Archfx/FPGA-DepthMap-Basys3/IMG/Bat2.png

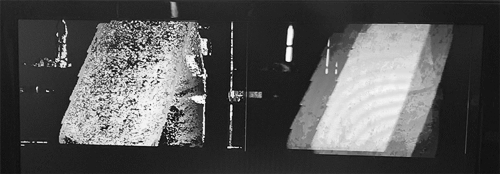
IMG/Bat2.png
