Archfx/FPGA-DepthMap-Basys3/IMG/Bat.png

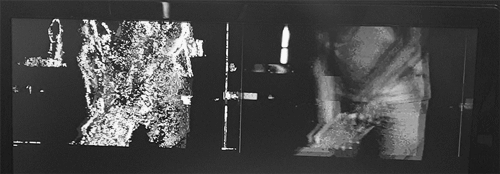
IMG/Bat.png
