Archfx/FPGA-DepthMap-Basys3/IMG/Bat_av_crop.png

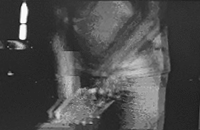
IMG/Bat_av_crop.png
