Archfx/FPGA-DepthMap-Basys3/IMG/Bat_crop.png

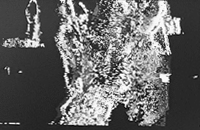
IMG/Bat_crop.png
