Archfx/FPGA-DepthMap-Basys3/(threads)

Thread 1 (2020-06-18):

Error during Synthesis/Implementation due to "Black box cells" (Missing module files?)

WillPastor, 2020-06-18:
Hi, I'm trying to get this working on my Basys 3, but it seems that there are files missing, which are required by Vivado to successfully run through Implementation. The missing files are those defining the modules: disparity_ram , frame_buffer , and Clocks, although I believe I can easily replace the missing "Clocks" by using Xilinx' Clocking Wizard in Core Gen. For the others, would you be willing to either upload these files, or if you are unable to provide them, give me some information on the functionality of those modules so I may try to re-write them myself?
Any help would be greatly appreciated.

Here are the error messages after implementation fails:
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

Archfx, 2020-06-18:
Hi Will,
all these missing modules were generated using inbuilt IP cores. Since you have solved the clocking issue, I believe you would be able to configure the Blockram issue as well if I give you their parameters.

Archfx, 2020-06-18:
All the buffers are dual-port block rams and configurations are as follows,

**Disparity_ram:**
           **width** : 8bits
           **Depth** : 76800 (320*240)
           _does not include an enable pin_

**Frame_buffer:**
           **width** : 4bits
           **Depth** : 76800 (320*240)
           _Includes an enable pin_

WillPastor, 2020-06-19:
Thank you! Everything seems to be working now except for the Clocks. I'm getting an error after Implementation:
`[Timing 38-282] The design failed to meet the timing requirements. Please see the timing summary report for details on the timing violations.`

I probably have some of the settings wrong in the Clocking Wizard. Could you tell me what settings you used?
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

Archfx, 2020-06-20:
This might be due to the fact that later I changed CLK_MAIN (100Hz) clock to 50Hz, Please try changing it.

WillPastor, 2020-06-22:
Thank you very much for your help. It finished generating a bitstream and writing to the FPGA.

I also wanted to ask if you could provide documentation on what the buttons are supposed to do?

Additionally, I would like to use code from this project for an academic project. I do not see any license info in this repo, so I wanted to make sure I know your preferences on use of your code and how to properly give credit.

I could open a new issue for these if you would prefer, since the original problem is solved.
Thanks for all the help!

Archfx, 2020-06-23:
Great, I have updated the repo with an MIT license, You can include my name "Aruna Jayasena" for credits. Regarding the buttons, I will update the documentation.  I will close this Issue since the original issue has been fixed now. If you have any other, feel free to open a new one. Good luck!!!

Closed 2020-06-23.

Thread 3 (2020-07-14):

Noise in Camera Signal

WillPastor, 2020-07-14:
So, I have both cameras connected and the bitstream sent to my Basys3 board. Everything is working correctly, but the VGA output is showing that the cameras must be picking up a **lot** of noise across the entire frame, and it interferes a lot with the disparity map from what I see on the screen. Do you have any suggestions or thoughts on this issue? The setting is a well-lit (but not super-brightly lit) indoor room, if that matters. Thanks!

Archfx, 2020-07-15:
This must be due to some sort of error or lose connection in the wiring, Better to check the cameras individually and recheck the connections, I glued the connectors with hot glue to get rid of the same issue. Light is affecting the performance because OV7670 cameras are very weak in low light. Also, don't forget to focus the lens on both the cameras correctly. :smile:

WillPastor, 2020-07-19:
All the wires are now firmly in place, but I'm still having some trouble. It seems like some of the issue(s) might be caused by timing violations. I'm very new to FPGA development so I did not realize at first how much this would affect performance. I've tried using more aggressive settings for optimization during synthesis and implementation, but not much luck, all runs still have timing violation. Do you have any suggestions such as what timing constraints you used, and/or what directives you used for synthesis/implementation? I was just going through the Timing Constraints Wizard and I am not too sure what would be good values to enter for many of the fields like input and output delays, etc.
Thanks again!

Archfx, 2020-07-23:
I guess you will be able to optimize the parameters to obtain good results, But I suggest you to test each and individual cameras separately, As I had to do lot of trial and error to find the issues. For some issues, I had to change the internal register values of the cameras.

Closed 2023-05-22.

Thread 4 (2020-07-22):

160x120 Resolution Address Width

WillPastor, 2020-07-22:
Hi, I tried setting the resolution to 160x120 by changing these lines in depthmap.vhd from:
```
rez_160x120 <= '0';
rez_320x240 <= '1';
```
to:
```
rez_160x120 <= '1';
rez_320x240 <= '0';
```
I also changed the depth of the Dual Port RAMs to 19200 (160*120) instead of 76800. This led to some issues, since the Address Width is now 15 bits instead of 17. What is the intended way to make the lower resolution work? I tried updating the width to 15 bits throughout all of the code, but this continued to give me errors. Right now I'm seeing if it works to just leave the rest of the code as it was (17 bit address), but in the port-mapping for the RAM instances, use only 15 bits of whatever signal it is connected to. For example:
```Inst_frame_buffer_l: frame_buffer PORT MAP(
		addrb => address_left(14 downto 0),
		clkb   => clk_camera,--CLK100,
		doutb  => rddata_l,
		enb    =>'1',
		clka   => ov7670_pclk_l,
		addra => wr_addr_l(14 downto 0),```
I am worried this might cause issues later on even if it works at the moment, unless this is the intended way to handle it?
Thanks!

Archfx, 2020-07-23:
Actually this was the intended method for my application to change the resolution, Therefore it won't affect the results. I couldn't have found a way to modify the block ram depths using an API, Therefore I kept it like that. :smile:

Closed 2021-08-04.
