Archfx/FPGA-DepthMap-Basys3/depthMap.runs/synth_1/.Xil/DepthMap_propImpl.xdc

set_property SRC_FILE_INFO {cfile:c:/Users/Aruna/Documents/Vivado/DepthMap_implementaion_basys3_320x240_With_UART/depthMap.srcs/sources_1/ip/Clocks/Clocks.xdc rfile:../../../depthMap.srcs/sources_1/ip/Clocks/Clocks.xdc id:1 order:EARLY scoped_inst:Inst_ClockDev/inst} [current_design]
set_property SRC_FILE_INFO {cfile:C:/Users/Aruna/Documents/Vivado/DepthMap_implementaion_basys3_320x240_With_UART/depthMap.srcs/constrs_1/imports/new/basys3_xdc.xdc rfile:../../../depthMap.srcs/constrs_1/imports/new/basys3_xdc.xdc id:2} [current_design]
current_instance Inst_ClockDev/inst
set_property src_info {type:SCOPED_XDC file:1 line:57 export:INPUT save:INPUT read:READ} [current_design]
set_input_jitter [get_clocks -of_objects [get_ports clk_in1]] 0.1
current_instance
set_property src_info {type:XDC file:2 line:5 export:INPUT save:INPUT read:READ} [current_design]
set_property PACKAGE_PIN W5 [get_ports clk100]
set_property src_info {type:XDC file:2 line:13 export:INPUT save:INPUT read:READ} [current_design]
set_property PACKAGE_PIN G19 [get_ports {vga_r[0]}]
set_property src_info {type:XDC file:2 line:15 export:INPUT save:INPUT read:READ} [current_design]
set_property PACKAGE_PIN H19 [get_ports {vga_r[1]}]
set_property src_info {type:XDC file:2 line:17 export:INPUT save:INPUT read:READ} [current_design]
set_property PACKAGE_PIN J19 [get_ports {vga_r[2]}]
set_property src_info {type:XDC file:2 line:19 export:INPUT save:INPUT read:READ} [current_design]
set_property PACKAGE_PIN N19 [get_ports {vga_r[3]}]
set_property src_info {type:XDC file:2 line:21 export:INPUT save:INPUT read:READ} [current_design]
set_property PACKAGE_PIN N18 [get_ports {vga_b[0]}]
set_property src_info {type:XDC file:2 line:23 export:INPUT save:INPUT read:READ} [current_design]
set_property PACKAGE_PIN L18 [get_ports {vga_b[1]}]
set_property src_info {type:XDC file:2 line:25 export:INPUT save:INPUT read:READ} [current_design]
set_property PACKAGE_PIN K18 [get_ports {vga_b[2]}]
set_property src_info {type:XDC file:2 line:27 export:INPUT save:INPUT read:READ} [current_design]
set_property PACKAGE_PIN J18 [get_ports {vga_b[3]}]
set_property src_info {type:XDC file:2 line:29 export:INPUT save:INPUT read:READ} [current_design]
set_property PACKAGE_PIN J17 [get_ports {vga_g[0]}]
set_property src_info {type:XDC file:2 line:31 export:INPUT save:INPUT read:READ} [current_design]
set_property PACKAGE_PIN H17 [get_ports {vga_g[1]}]
set_property src_info {type:XDC file:2 line:33 export:INPUT save:INPUT read:READ} [current_design]
set_property PACKAGE_PIN G17 [get_ports {vga_g[2]}]
set_property src_info {type:XDC file:2 line:35 export:INPUT save:INPUT read:READ} [current_design]
set_property PACKAGE_PIN D17 [get_ports {vga_g[3]}]
set_property src_info {type:XDC file:2 line:37 export:INPUT save:INPUT read:READ} [current_design]
set_property PACKAGE_PIN P19 [get_ports vga_hsync]
set_property src_info {type:XDC file:2 line:39 export:INPUT save:INPUT read:READ} [current_design]
set_property PACKAGE_PIN R19 [get_ports vga_vsync]
set_property src_info {type:XDC file:2 line:43 export:INPUT save:INPUT read:READ} [current_design]
set_property PACKAGE_PIN U16 [get_ports {config_finished_l}]
set_property src_info {type:XDC file:2 line:46 export:INPUT save:INPUT read:READ} [current_design]
set_property PACKAGE_PIN L1 [get_ports {config_finished_r}]
set_property src_info {type:XDC file:2 line:52 export:INPUT save:INPUT read:READ} [current_design]
set_property PACKAGE_PIN W19 [get_ports btnl]
set_property src_info {type:XDC file:2 line:54 export:INPUT save:INPUT read:READ} [current_design]
set_property PACKAGE_PIN T17 [get_ports btnr]
set_property src_info {type:XDC file:2 line:56 export:INPUT save:INPUT read:READ} [current_design]
set_property PACKAGE_PIN T18 [get_ports btnp]
set_property src_info {type:XDC file:2 line:58 export:INPUT save:INPUT read:READ} [current_design]
set_property PACKAGE_PIN U17 [get_ports btnm]
set_property src_info {type:XDC file:2 line:61 export:INPUT save:INPUT read:READ} [current_design]
set_property PACKAGE_PIN V17 [get_ports {btnc}]
set_property src_info {type:XDC file:2 line:74 export:INPUT save:INPUT read:READ} [current_design]
set_property PACKAGE_PIN A14 [get_ports {ov7670_pwdn_l}]
set_property src_info {type:XDC file:2 line:77 export:INPUT save:INPUT read:READ} [current_design]
set_property PACKAGE_PIN A16 [get_ports {ov7670_data_l[0]}]
set_property src_info {type:XDC file:2 line:80 export:INPUT save:INPUT read:READ} [current_design]
set_property PACKAGE_PIN B15 [get_ports {ov7670_data_l[2]}]
set_property src_info {type:XDC file:2 line:83 export:INPUT save:INPUT read:READ} [current_design]
set_property PACKAGE_PIN B16 [get_ports {ov7670_data_l[4]}]
set_property src_info {type:XDC file:2 line:86 export:INPUT save:INPUT read:READ} [current_design]
set_property PACKAGE_PIN A15 [get_ports {ov7670_reset_l}]
set_property src_info {type:XDC file:2 line:89 export:INPUT save:INPUT read:READ} [current_design]
set_property PACKAGE_PIN A17 [get_ports {ov7670_data_l[1]}]
set_property src_info {type:XDC file:2 line:92 export:INPUT save:INPUT read:READ} [current_design]
set_property PACKAGE_PIN C15 [get_ports {ov7670_data_l[3]}]
set_property src_info {type:XDC file:2 line:95 export:INPUT save:INPUT read:READ} [current_design]
set_property PACKAGE_PIN C16 [get_ports {ov7670_data_l[5]}]
set_property src_info {type:XDC file:2 line:101 export:INPUT save:INPUT read:READ} [current_design]
set_property PACKAGE_PIN K17 [get_ports {ov7670_data_l[6]}]
set_property src_info {type:XDC file:2 line:104 export:INPUT save:INPUT read:READ} [current_design]
set_property PACKAGE_PIN M18 [get_ports ov7670_xclk_l]
set_property src_info {type:XDC file:2 line:107 export:INPUT save:INPUT read:READ} [current_design]
set_property PACKAGE_PIN N17 [get_ports ov7670_href_l]
set_property src_info {type:XDC file:2 line:110 export:INPUT save:INPUT read:READ} [current_design]
set_property PACKAGE_PIN P18 [get_ports ov7670_siod_l]
set_property src_info {type:XDC file:2 line:114 export:INPUT save:INPUT read:READ} [current_design]
set_property PACKAGE_PIN L17 [get_ports {ov7670_data_l[7]}]
set_property src_info {type:XDC file:2 line:117 export:INPUT save:INPUT read:READ} [current_design]
set_property PACKAGE_PIN M19 [get_ports ov7670_pclk_l]
set_property src_info {type:XDC file:2 line:119 export:INPUT save:INPUT read:READ} [current_design]
set_property CLOCK_DEDICATED_ROUTE FALSE [get_nets {ov7670_pclk_l_IBUF}]
set_property src_info {type:XDC file:2 line:121 export:INPUT save:INPUT read:READ} [current_design]
set_property PACKAGE_PIN P17 [get_ports ov7670_vsync_l]
set_property src_info {type:XDC file:2 line:124 export:INPUT save:INPUT read:READ} [current_design]
set_property PACKAGE_PIN R18 [get_ports ov7670_sioc_l]
set_property src_info {type:XDC file:2 line:130 export:INPUT save:INPUT read:READ} [current_design]
set_property PACKAGE_PIN J1 [get_ports {ov7670_pwdn_r}]
set_property src_info {type:XDC file:2 line:133 export:INPUT save:INPUT read:READ} [current_design]
set_property PACKAGE_PIN L2 [get_ports {ov7670_data_r[0]}]
set_property src_info {type:XDC file:2 line:136 export:INPUT save:INPUT read:READ} [current_design]
set_property PACKAGE_PIN J2 [get_ports {ov7670_data_r[2]}]
set_property src_info {type:XDC file:2 line:139 export:INPUT save:INPUT read:READ} [current_design]
set_property PACKAGE_PIN G2 [get_ports {ov7670_data_r[4]}]
set_property src_info {type:XDC file:2 line:142 export:INPUT save:INPUT read:READ} [current_design]
set_property PACKAGE_PIN H1 [get_ports {ov7670_reset_r}]
set_property src_info {type:XDC file:2 line:145 export:INPUT save:INPUT read:READ} [current_design]
set_property PACKAGE_PIN K2 [get_ports {ov7670_data_r[1]}]
set_property src_info {type:XDC file:2 line:148 export:INPUT save:INPUT read:READ} [current_design]
set_property PACKAGE_PIN H2 [get_ports {ov7670_data_r[3]}]
set_property src_info {type:XDC file:2 line:151 export:INPUT save:INPUT read:READ} [current_design]
set_property PACKAGE_PIN G3 [get_ports {ov7670_data_r[5]}]
set_property src_info {type:XDC file:2 line:157 export:INPUT save:INPUT read:READ} [current_design]
set_property PACKAGE_PIN J3 [get_ports {ov7670_data_r[6]}]
set_property src_info {type:XDC file:2 line:160 export:INPUT save:INPUT read:READ} [current_design]
set_property PACKAGE_PIN L3 [get_ports ov7670_xclk_r]
set_property src_info {type:XDC file:2 line:163 export:INPUT save:INPUT read:READ} [current_design]
set_property PACKAGE_PIN M2 [get_ports ov7670_href_r]
set_property src_info {type:XDC file:2 line:166 export:INPUT save:INPUT read:READ} [current_design]
set_property PACKAGE_PIN N2 [get_ports ov7670_siod_r]
set_property src_info {type:XDC file:2 line:170 export:INPUT save:INPUT read:READ} [current_design]
set_property PACKAGE_PIN K3 [get_ports {ov7670_data_r[7]}]
set_property src_info {type:XDC file:2 line:173 export:INPUT save:INPUT read:READ} [current_design]
set_property PACKAGE_PIN M3 [get_ports ov7670_pclk_r]
set_property src_info {type:XDC file:2 line:175 export:INPUT save:INPUT read:READ} [current_design]
set_property CLOCK_DEDICATED_ROUTE FALSE [get_nets {ov7670_pclk_r_IBUF}]
set_property src_info {type:XDC file:2 line:177 export:INPUT save:INPUT read:READ} [current_design]
set_property PACKAGE_PIN M1 [get_ports ov7670_vsync_r]
set_property src_info {type:XDC file:2 line:180 export:INPUT save:INPUT read:READ} [current_design]
set_property PACKAGE_PIN N1 [get_ports ov7670_sioc_r]
set_property src_info {type:XDC file:2 line:187 export:INPUT save:INPUT read:READ} [current_design]
set_property PACKAGE_PIN A18 [get_ports TxD]
