Archfx/FPGA-DepthMap-Basys3/depthMap.srcs/sources_1/imports/ov7670_controller_left.vhd

----------------------------------------------------------------------------------
-- Engineer: Mike Field <hamster@snap.net.nz>
-- 
-- Description: Controller for the OV760 camera - transferes registers to the 
--              camera over an I2C like bus

-- This file is borrowed from https://github.com/laurivosandi/hdl 
-- MIT LICENSE can be found here for this file https://github.com/laurivosandi/hdl/blob/master/LICENSE
----------------------------------------------------------------------------------
library IEEE;
use IEEE.STD_LOGIC_1164.ALL;
use IEEE.NUMERIC_STD.ALL;

entity ov7670_controller_left is
    Port ( clk   : in    STD_LOGIC;
			  resend :in    STD_LOGIC;
			  config_finished : out std_logic;
           sioc  : out   STD_LOGIC;
           siod  : inout STD_LOGIC;
           reset : out   STD_LOGIC;
           pwdn  : out   STD_LOGIC;
			  xclk  : out   STD_LOGIC
);
end ov7670_controller_left;

architecture Behavioral of ov7670_controller_left is
	COMPONENT ov7670_registers_left
	PORT(
		clk      : IN std_logic;
		advance  : IN std_logic;          
		resend   : in STD_LOGIC;
		command  : OUT std_logic_vector(15 downto 0);
		finished : OUT std_logic
		);
	END COMPONENT;

	COMPONENT i2c_sender
	PORT(
		clk   : IN std_logic;
		send  : IN std_logic;
		taken : out std_logic;
		id    : IN std_logic_vector(7 downto 0);
		reg   : IN std_logic_vector(7 downto 0);
		value : IN std_logic_vector(7 downto 0);    
		siod  : INOUT std_logic;      
		sioc  : OUT std_logic
		);
	END COMPONENT;

	signal sys_clk  : std_logic := '0';	
	signal command  : std_logic_vector(15 downto 0);
	signal finished : std_logic := '0';
	signal taken    : std_logic := '0';
	signal send     : std_logic;

	constant camera_address : std_logic_vector(7 downto 0) := x"42"; -- 42"; -- Device write ID - see top of page 11 of data sheet
begin
   config_finished <= finished;
	
	send <= not finished;
	Inst_i2c_sender: i2c_sender PORT MAP(
		clk   => clk,
		taken => taken,
		siod  => siod,
		sioc  => sioc,
		send  => send,
		id    => camera_address,
		reg   => command(15 downto 8),
		value => command(7 downto 0)
	);

	reset <= '1'; 						-- Normal mode
	pwdn  <= '0'; 						-- Power device up
	xclk  <= sys_clk;
	
	Inst_ov7670_registers_left: ov7670_registers_left PORT MAP(
		clk      => clk,
		advance  => taken,
		command  => command,
		finished => finished,
		resend   => resend
	);

	process(clk)
	begin
		if rising_edge(clk) then
			sys_clk <= not sys_clk;
		end if;
	end process;
end Behavioral;
