Archfx/FPGA-DepthMap-Basys3/depthMap.srcs/sources_1/imports/vga.vhd

----------------------------------------------------------------------------------
library IEEE;
use IEEE.STD_LOGIC_1164.ALL;
use IEEE.STD_LOGIC_ARITH.ALL;
use IEEE.STD_LOGIC_UNSIGNED.ALL;



entity VGA is
    Port ( CLK25 : in  STD_LOGIC;									--  25 MHz							
			  clkout : out  STD_LOGIC;					
           rez_160x120 : IN std_logic;
           rez_320x240 : IN std_logic;
           Hsync,Vsync : out  STD_LOGIC;						
			  Nblank : out  STD_LOGIC;								
           activeArea : out  STD_LOGIC;
			  Nsync : out  STD_LOGIC;
			 avg_en : out  STD_LOGIC );	
end VGA;

architecture Behavioral of VGA is
signal Hcnt:STD_LOGIC_VECTOR(9 downto 0):="0000000000";		
signal Vcnt:STD_LOGIC_VECTOR(9 downto 0):="1000001000";		
signal video:STD_LOGIC;

constant HM: integer :=799;	
constant HD: integer :=640;	
constant HF: integer :=16;		
constant HB: integer :=48;		
constant HR: integer :=96;		
constant VM: integer :=524;	
constant VD: integer :=480;	
constant VF: integer :=10;		
constant VB: integer :=33;		
constant VR: integer :=2;		

begin


	process(CLK25)
		begin
			if (CLK25'event and CLK25='1') then
				if (Hcnt = HM) then
					Hcnt <= "0000000000";
               if (Vcnt= VM) then
                  Vcnt <= "0000000000";
                  activeArea <= '1';
               else
                  if rez_160x120 = '1' then
                     if vCnt < 120-1 then
                        activeArea <= '1';
                     end if;
                  elsif rez_320x240 = '1' then
                     if vCnt < 240-1 then
                        activeArea <= '1';
                     end if;
                  else
                     if vCnt < 480-1 then
                        activeArea <= '1';
                     end if;
                  end if;
                  Vcnt <= Vcnt+1;
               end if;
				else
               if rez_160x120 = '1' then
                  if hcnt = 160-1 then
                     activeArea <= '0';
                  end if;
               elsif rez_320x240 = '1' then
                  if hcnt < 320 then
                     avg_en <= '0';
                  else
                    avg_en <= '1';
                  end if;
                  if hcnt = 640-1 then
                     activeArea <= '0';
                  end if;
               else
                  if hcnt = 640-1 then
                     activeArea <= '0';
                  end if;
               end if;
					Hcnt <= Hcnt + 1;
				end if;
			end if;
		end process;
----------------------------------------------------------------

-- Hsync:
	process(CLK25)
		begin
			if (CLK25'event and CLK25='1') then
				if (Hcnt >= (HD+HF) and Hcnt <= (HD+HF+HR-1)) then   
					Hsync <= '0';
				else
					Hsync <= '1';
				end if;
			end if;
		end process;
----------------------------------------------------------------

--  Vsync:
	process(CLK25)
		begin
			if (CLK25'event and CLK25='1') then
				if (Vcnt >= (VD+VF) and Vcnt <= (VD+VF+VR-1)) then  ---Vcnt >= 490 and vcnt<= 491
					Vsync <= '0';
				else
					Vsync <= '1';
				end if;
			end if;
		end process;
----------------------------------------------------------------


Nsync <= '1';
video <= '1' when (Hcnt < HD) and (Vcnt < VD)			
	      else '0';
Nblank <= video;
clkout <= CLK25;

		
end Behavioral;
