Archfx/FPGA-DepthMap-Basys3/(commit log)

2019-08-13 Switch case address values
2019-08-14 Failed attempt_2 cant access Bram simultaniously
    [disparity_generator.vhd]
2019-08-18 There is a problem with clocks
    [disparity_generator.vhd]
2019-08-18 Corrected Disparity buffer clock error
    [depthmap.vhd, disparity_generator.vhd]
2019-08-19 Basic counting error fixed
    [disparity_generator.vhd]
2019-08-20 320x240 resolution with 8bit outputfew bugs fixed
    [DepthMap_propImpl.xdc, RGB.vhd, address_Generator.vhd, basys3_xdc.xdc, depthmap.vhd, disparity_generator.vhd, ov7670_capture.vhd]
2019-09-04 Removed auto exposure correction from cameras
    [ov7670_registers.vhd]
2019-09-07 Working on Exposure correction of right camera
    [DepthMap_propImpl.xdc, Image_Rectification.vhd, basys3_xdc.xdc, depthmap.vhd, disparity_generator.vhd, ov7670_registers.vhd]
2019-09-07 I2C exposure correction added, Testing in progress
    [DepthMap_propImpl.xdc, Image_Rectification.vhd, depthmap.vhd, ov7670_controller_left.vhd, ov7670_controller_right.vhd, ov7670_registers_left.vhd, ov7670_registers_right.vhd]
2019-09-07 Right camera exposure issue fixed and SAD algorithm bug fixed
    [DepthMap_propImpl.xdc, Image_Rectification.vhd, depthmap.vhd, disparity_generator.vhd, ov7670_registers_left.vhd, ov7670_registers_right.vhd]
2019-09-09 Recitification module caliberated, Colour impabalance between two cameras is still fixing, New image added
    [DepthMap_propImpl.xdc, disparity_generator.vhd, ov7670_registers_left.vhd, ov7670_registers_right.vhd]
2019-10-28 UART added
2023-02-08 tranparent camera image adde
